juanluna97/Safety_Parachute_System/WebsiteExamples/Button .png

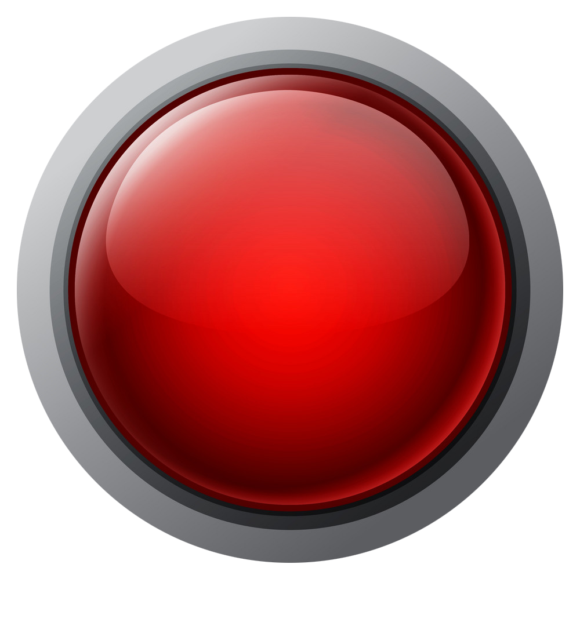
WebsiteExamples/Button .png
