juanluna97/Safety_Parachute_System/WebsiteExamples/Picture4.png

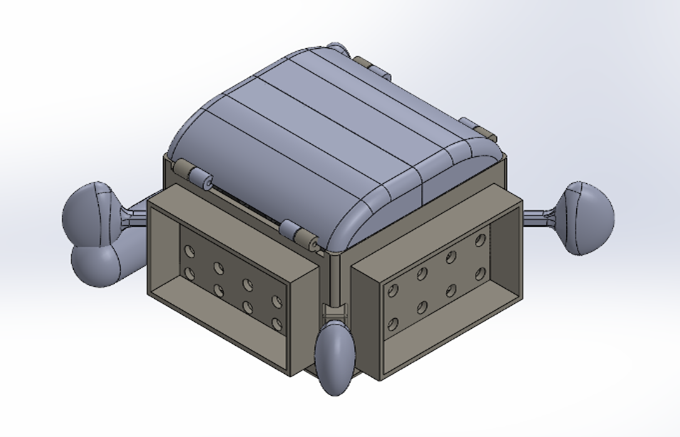
WebsiteExamples/Picture4.png
