juanluna97/Safety_Parachute_System/README.md

# Safety_Parachute_System
This repository houses all the documentation for our Senior Design Project.
