juanluna97/Safety_Parachute_System/WebsiteExamples/airplane-glyph.jpg

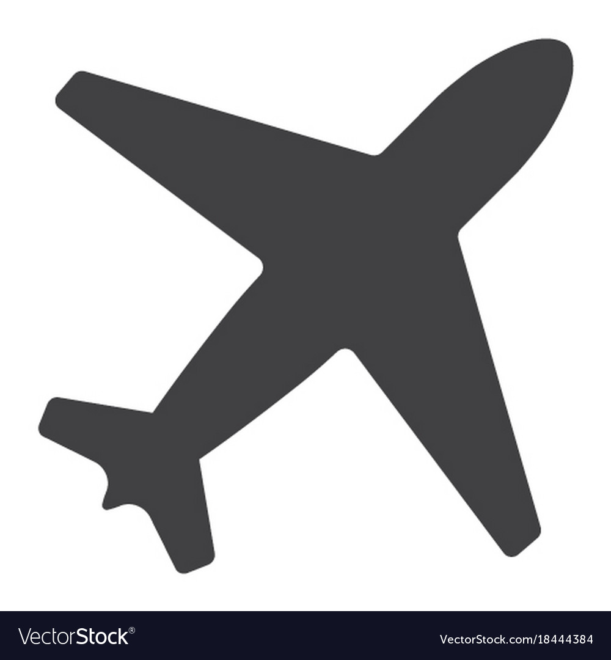
WebsiteExamples/airplane-glyph.jpg
