juanluna97/Safety_Parachute_System/WebsiteExamples/airplane-glyph.png

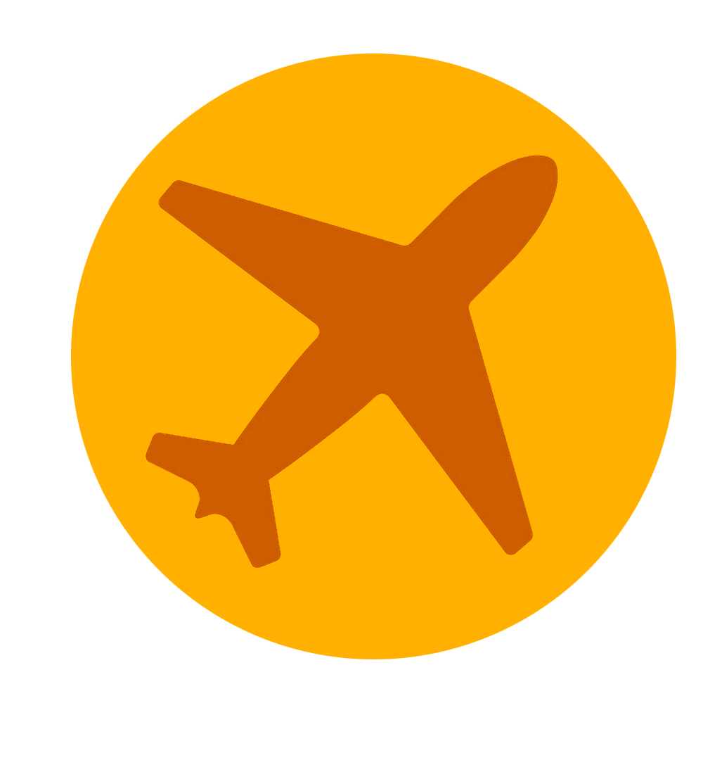
WebsiteExamples/airplane-glyph.png
