juanluna97/Safety_Parachute_System/WebsiteExamples/bluetoothbutton.png

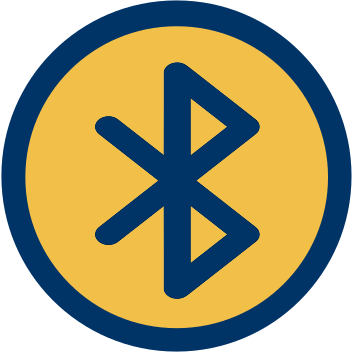
WebsiteExamples/bluetoothbutton.png
