juanluna97/Safety_Parachute_System/WebsiteExamples/button1-1.png

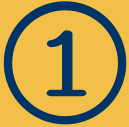
WebsiteExamples/button1-1.png
