juanluna97/Safety_Parachute_System/WebsiteExamples/button2-1.png

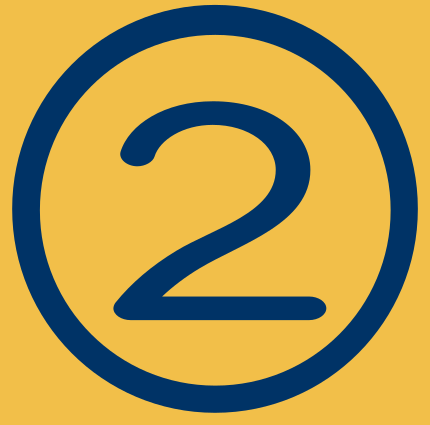
WebsiteExamples/button2-1.png
