juanluna97/Safety_Parachute_System/WebsiteExamples/button3.png

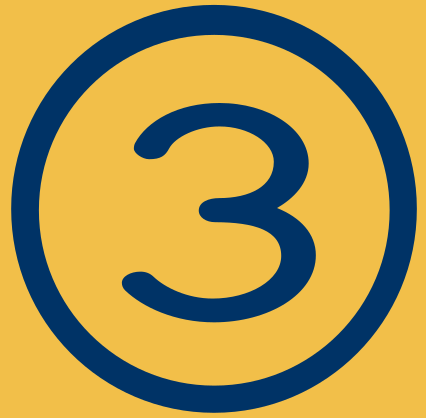
WebsiteExamples/button3.png
