juanluna97/Safety_Parachute_System/WebsiteExamples/button4.png

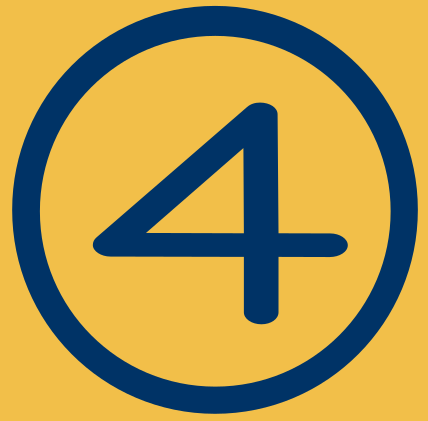
WebsiteExamples/button4.png
