juanluna97/Safety_Parachute_System/WebsiteExamples/button5.png

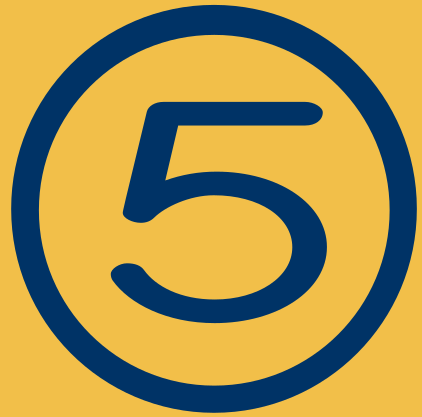
WebsiteExamples/button5.png
