juanluna97/Safety_Parachute_System/WebsiteExamples/button6.png

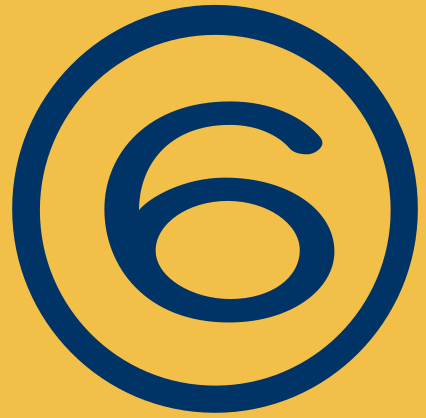
WebsiteExamples/button6.png
