juanluna97/Safety_Parachute_System/WebsiteExamples/downloadbutton.png

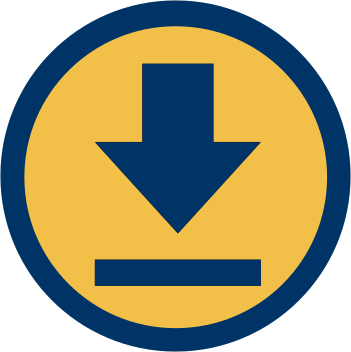
WebsiteExamples/downloadbutton.png
