juanluna97/Safety_Parachute_System/WebsiteExamples/More_pictures_for_homepage/Picture3.png

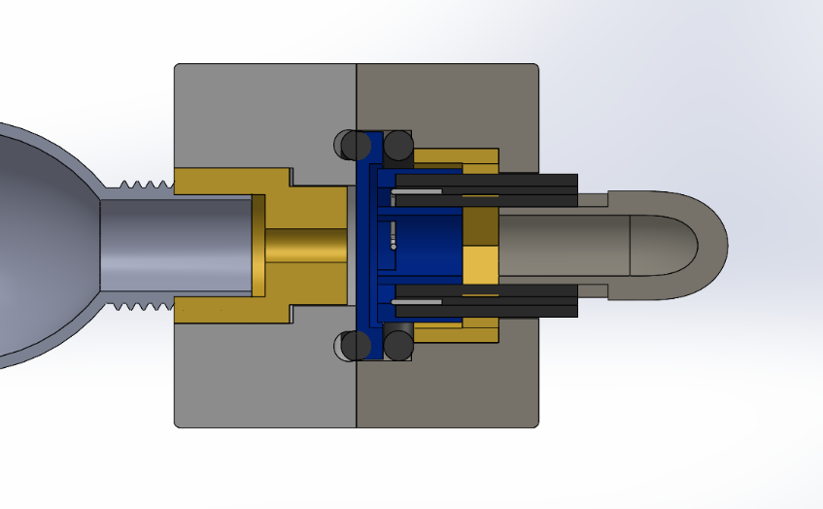
WebsiteExamples/More_pictures_for_homepage/Picture3.png
