juanluna97/Safety_Parachute_System/WebsiteExamples/More_pictures_for_homepage/Picture5.png

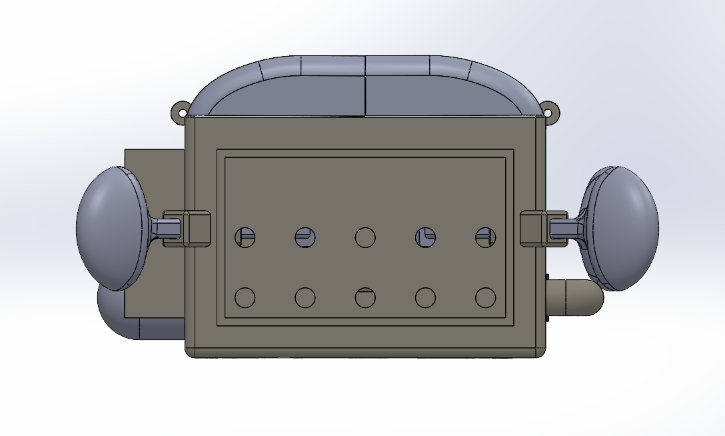
WebsiteExamples/More_pictures_for_homepage/Picture5.png
