juanluna97/Safety_Parachute_System/WebsiteExamples/on off-02.png

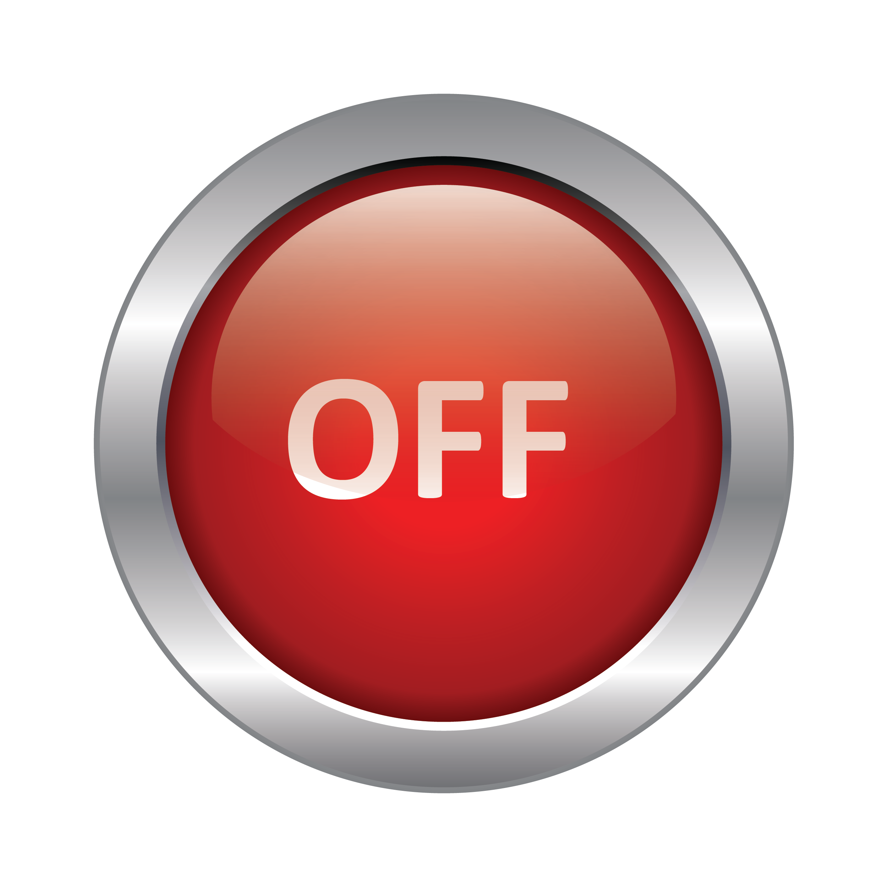
WebsiteExamples/on off-02.png
