juanluna97/Safety_Parachute_System/CAD Files/System Assembly.SLDASM

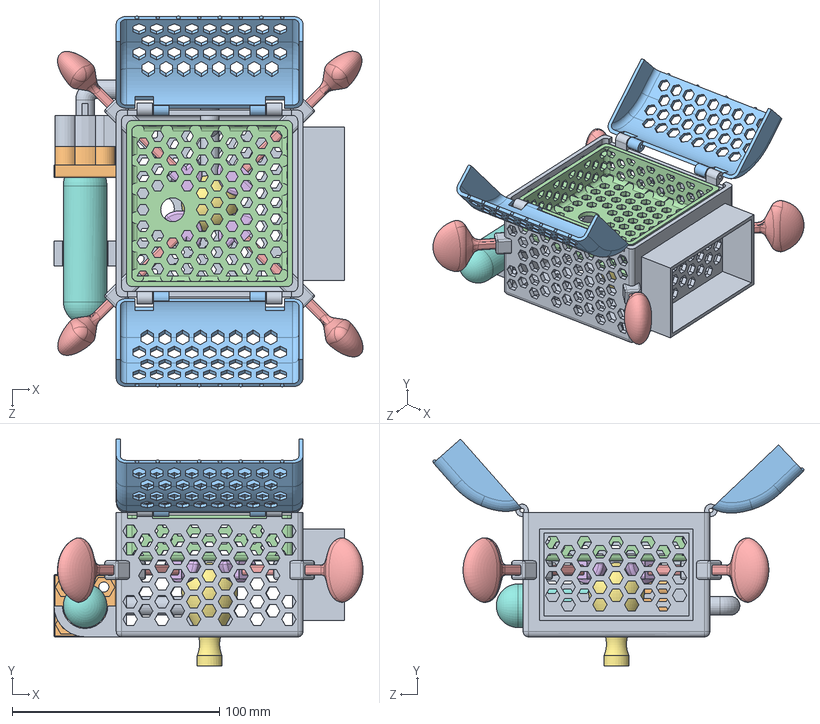
[picture p56: CAD file, 2021-04-25]
CAD Files/System Assembly.SLDASM
148.9 x 109.4 x 178.8 mm
Case 14
Interface 4
Curved Lid x 2
Parachute Cage 3
Square Flap Rod Loli V4 x 4
Square Flap Stop x 4
Balloon Prop
Cannister
