juanluna97/Safety_Parachute_System/CAD Files/Metal Ring.SLDPRT

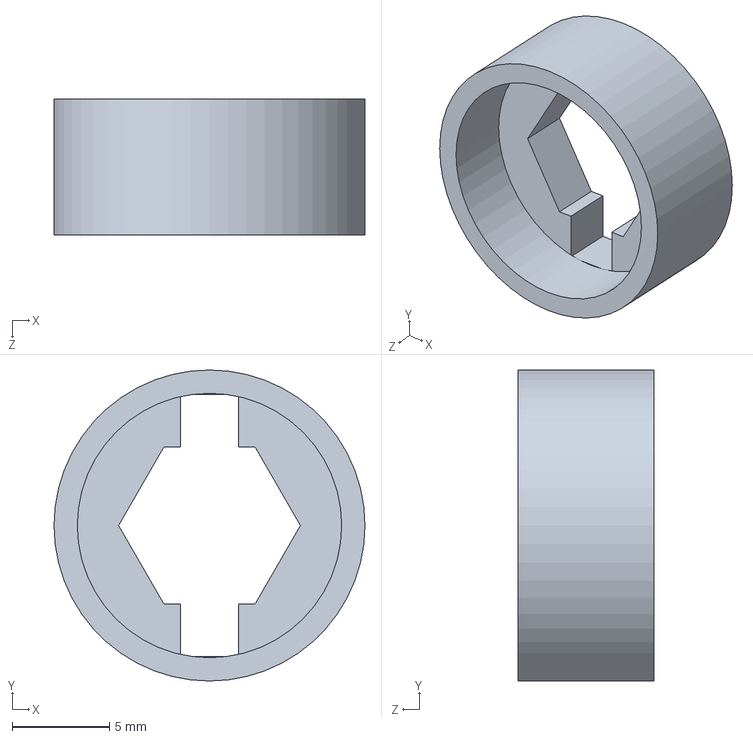
[picture p57: CAD file, 2021-04-25]
CAD Files/Metal Ring.SLDPRT
16.0 x 16.0 x 7.00 mm
