juanluna97/Safety_Parachute_System/CAD Files/Piercing Block.SLDPRT

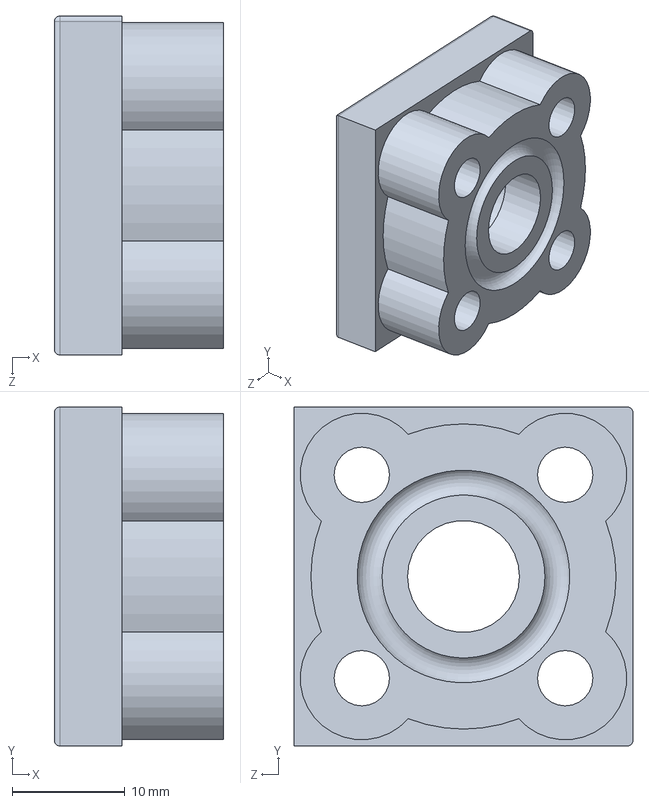
[picture p58: CAD file, 2021-04-25]
CAD Files/Piercing Block.SLDPRT
15.0 x 30.0 x 30.0 mm
