juanluna97/Safety_Parachute_System/CAD Files/Tablet Bottom.SLDPRT

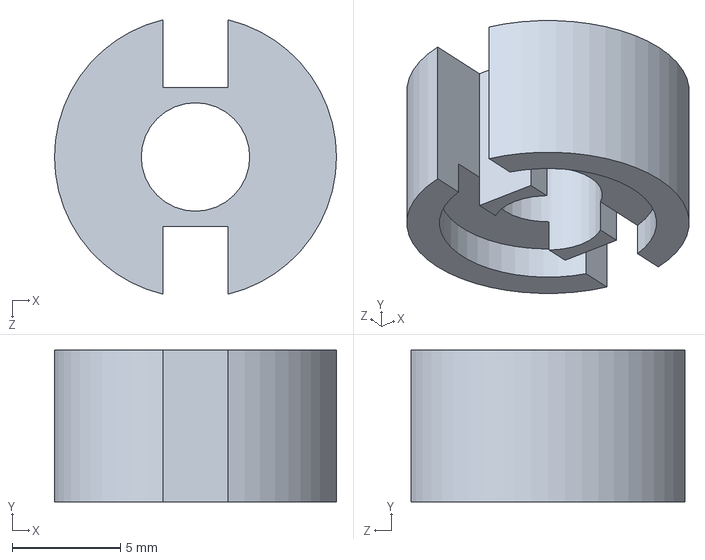
[picture p59: CAD file, 2021-04-25]
CAD Files/Tablet Bottom.SLDPRT
13.0 x 7.00 x 12.6 mm
