juanluna97/Safety_Parachute_System/CAD Files/O-ring.SLDPRT

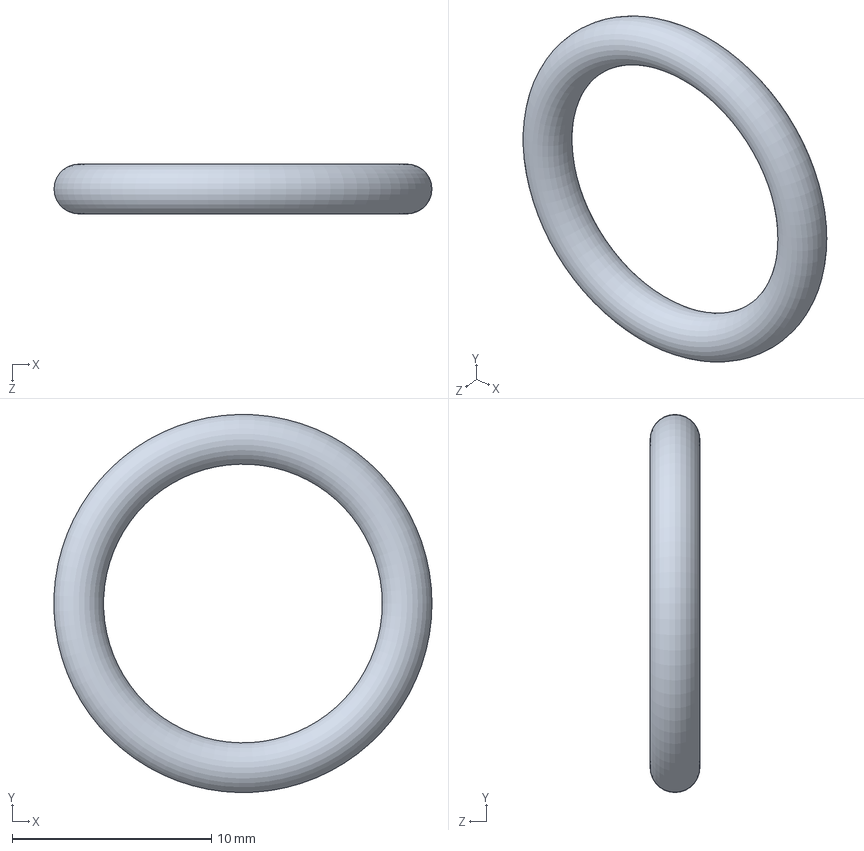
[picture p60: CAD file, 2021-04-25]
CAD Files/O-ring.SLDPRT
19.0 x 19.0 x 2.50 mm
