juanluna97/Safety_Parachute_System/CAD Files/FTS Flap Stop.SLDPRT

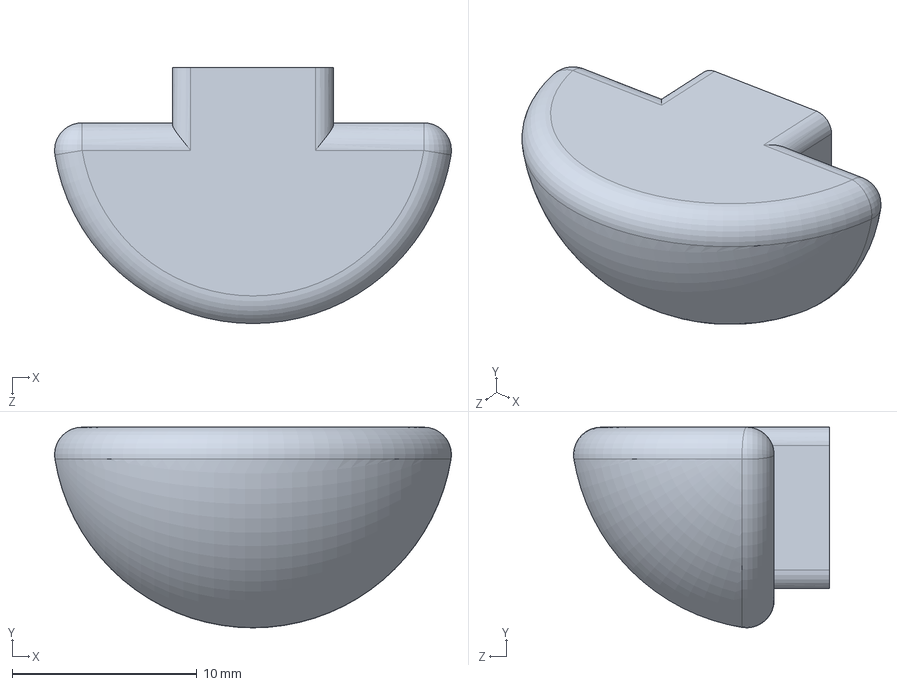
[picture p61: CAD file, 2021-04-25]
CAD Files/FTS Flap Stop.SLDPRT
21.5 x 10.9 x 13.9 mm
