juanluna97/Safety_Parachute_System/CAD Files/Hinge Rod.SLDPRT

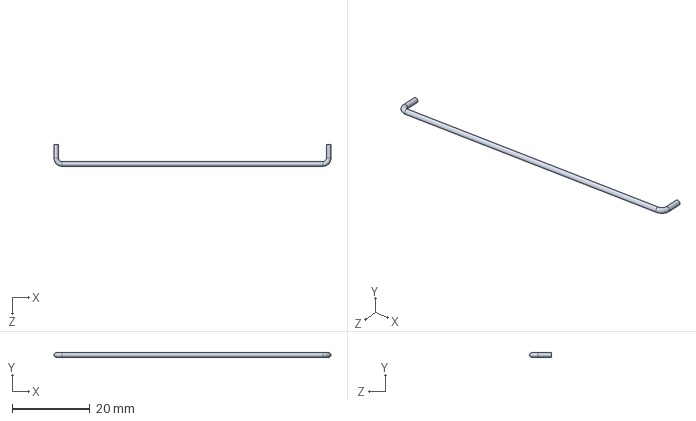
[picture p62: CAD file, 2021-04-25]
CAD Files/Hinge Rod.SLDPRT
71.2 x 1.20 x 5.60 mm
