juanluna97/Safety_Parachute_System/CAD Files/Jumper Cable Connector.SLDPRT

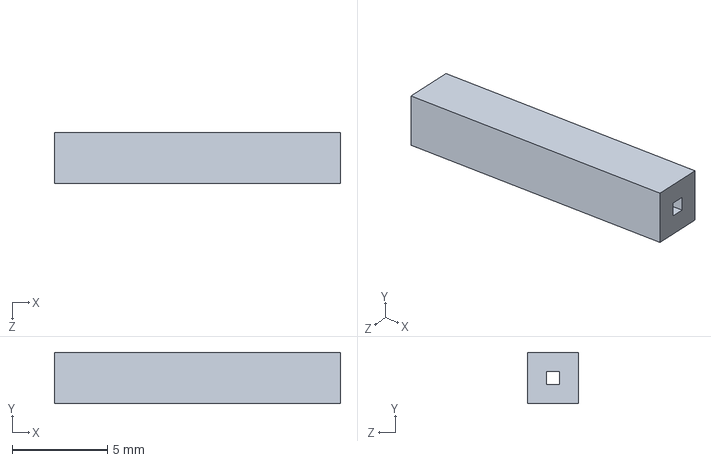
[picture p63: CAD file, 2021-04-25]
CAD Files/Jumper Cable Connector.SLDPRT
15.0 x 2.70 x 2.70 mm
