juanluna97/Safety_Parachute_System/CAD Files/Case.SLDPRT

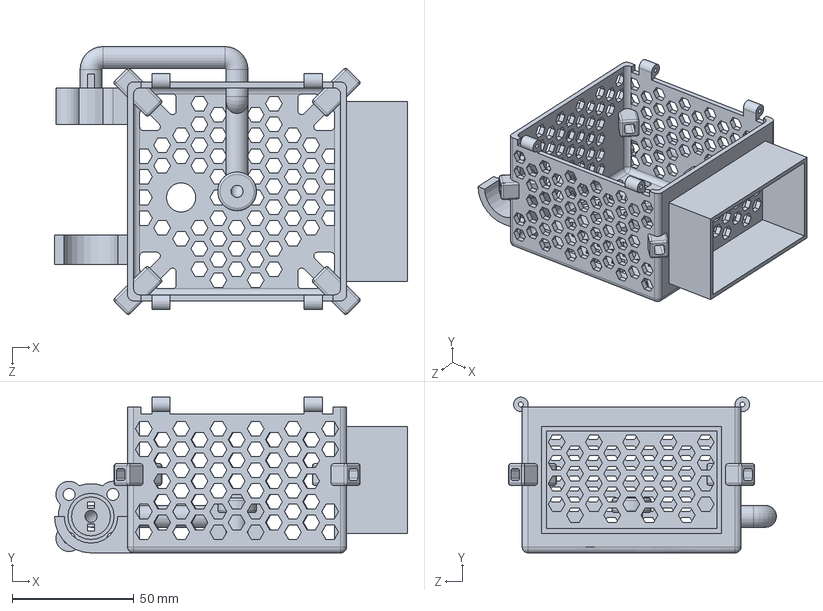
[picture p64: CAD file, 2021-04-25]
CAD Files/Case.SLDPRT
145.0 x 64.0 x 110.1 mm
