juanluna97/Safety_Parachute_System/CAD Files/Lid.SLDPRT

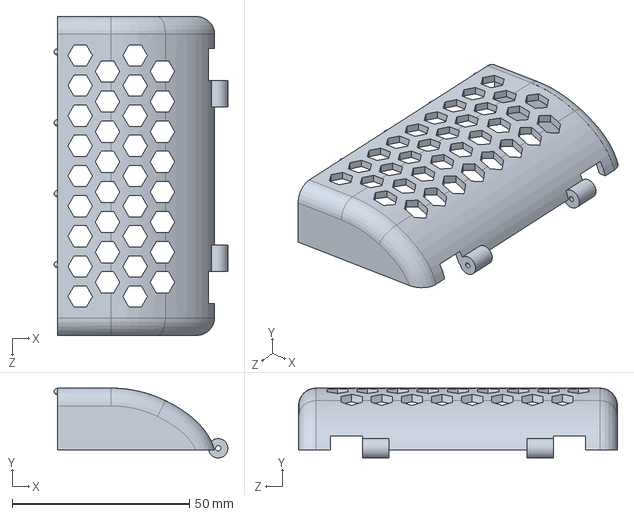
[picture p65: CAD file, 2021-04-25]
CAD Files/Lid.SLDPRT
49.0 x 19.7 x 90.0 mm
