juanluna97/Safety_Parachute_System/CAD Files/Piercing Device.SLDPRT

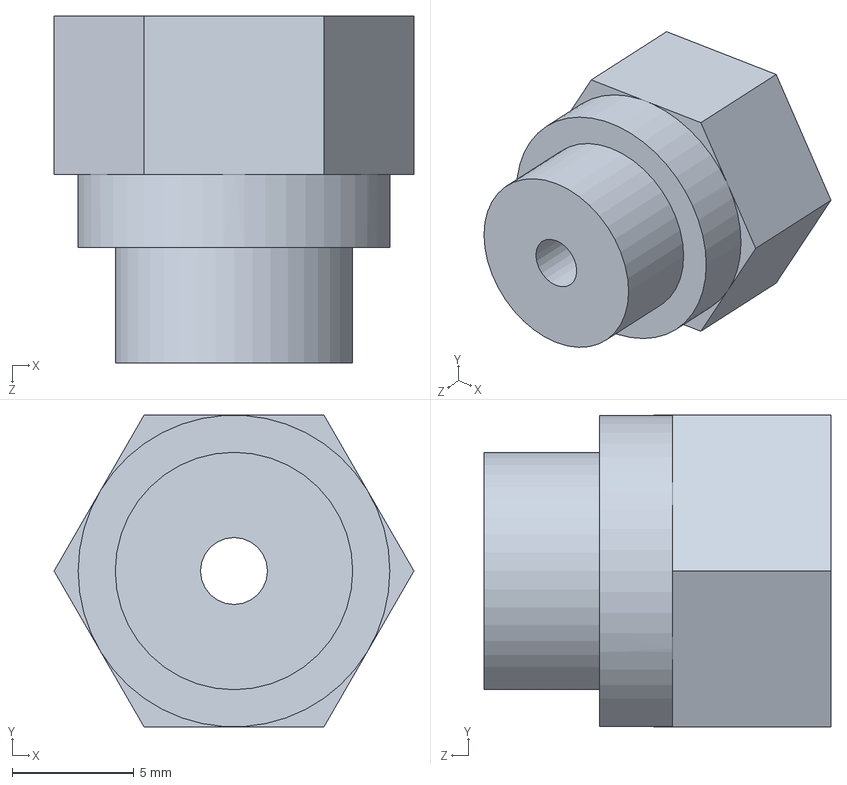
[picture p66: CAD file, 2021-04-25]
CAD Files/Piercing Device.SLDPRT
14.8 x 12.8 x 14.2 mm
