juanluna97/Safety_Parachute_System/CAD Files/CO2 Cartridge.SLDPRT

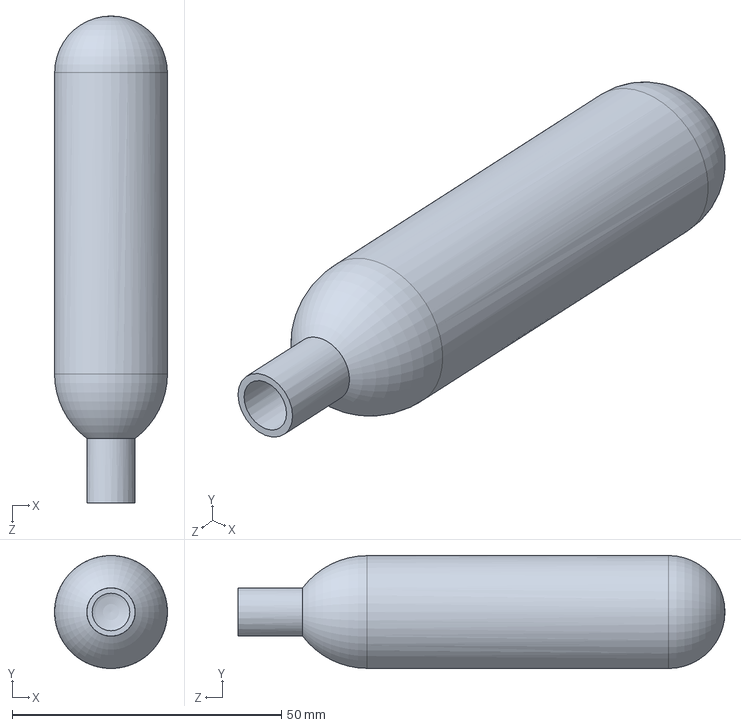
[picture p67: CAD file, 2021-04-25]
CAD Files/CO2 Cartridge.SLDPRT
21.0 x 21.0 x 90.5 mm
