juanluna97/Safety_Parachute_System/CAD Files/FTS Flap Rod.SLDPRT

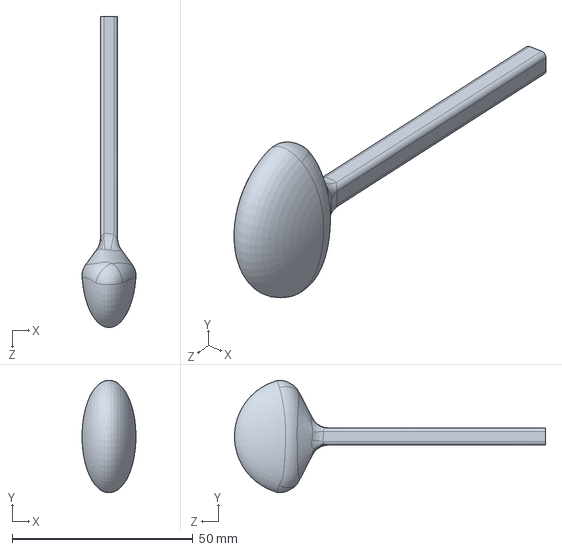
[picture p68: CAD file, 2021-04-25]
CAD Files/FTS Flap Rod.SLDPRT
14.9 x 31.1 x 85.9 mm
