juanluna97/Safety_Parachute_System/CAD Files/Tablet Top.SLDPRT

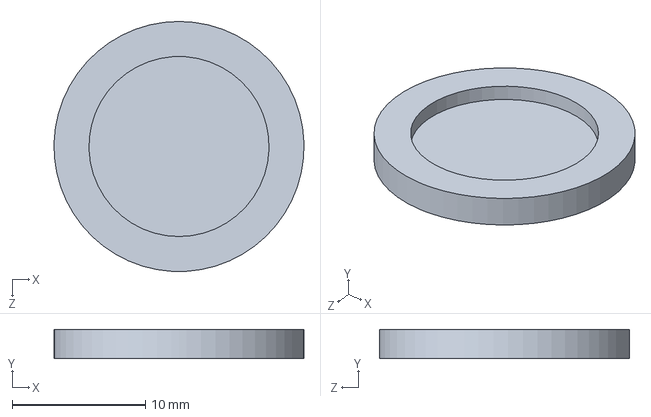
[picture p69: CAD file, 2021-04-25]
CAD Files/Tablet Top.SLDPRT
18.7 x 2.20 x 18.8 mm
