juanluna97/Safety_Parachute_System/CAD Files/Parachute Cage.SLDPRT

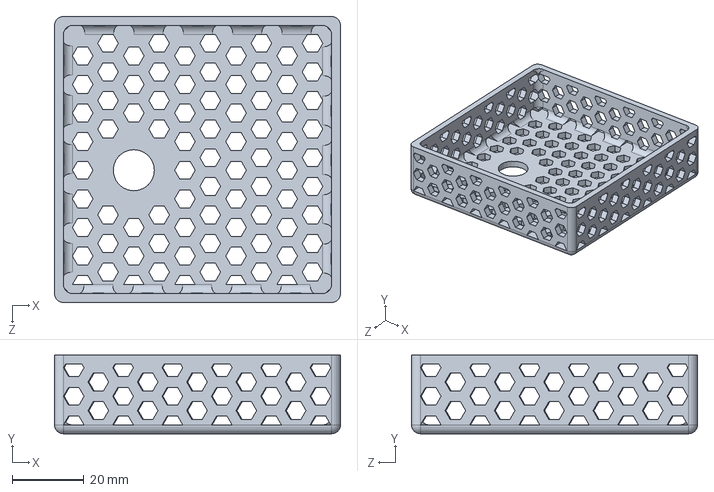
[picture p70: CAD file, 2021-04-25]
CAD Files/Parachute Cage.SLDPRT
80.0 x 22.0 x 80.0 mm
